Roxanne2603/ENGR1000J-Group1/docs/PROVENANCE.md

> 状态：现行交付快照｜2026-10-23｜未完成整车标定

# 来源、AI辅助与发布范围

源码和资料从组员本地ENGR100项目中按允许清单整理，当前主程序三文件与2026-10-23实际烧录版SHA256一致。本发布保留远程初始提交，不导入整个本地Git历史。

AI辅助：Codex用于控制程序整合、接线梳理、测试操作指导、日志分析、初始标定计算及本仓库整理；历史器件验收代码/记录包含DSH(DeepSeek)辅助。实物操作和“每轮几圈/滚动距离/运动方向”等由组员报告，AI没有把串口命令当作物理测量。报告应按课程要求如实披露实际使用的AI工具和环节。

原始程序保持字节不变。公开说明重写为可独立阅读的交付版本；不整份复制本地聊天、工作日志或课程草稿。上传日志中的本机路径和设备MAC已移除，公开验证JSON只保留可复核的源码/镜像哈希、参数与结果；源件SHA256在MANIFEST.json中记录。

重要边界：软件PASS、REACHED、编译和Flash校验不等于真实轮角、制动、载流或赛道验收；手工圈数/距离为初测。历史设计源件和旧接线Excel明确归档，不自动成为当前施工依据。

所有新增/更新文件都列在[MANIFEST.json](../MANIFEST.json)。无编译镜像、缓存、工具运行目录、令牌或聊天记录。发布前检查暂存清单、文本内容、相对链接和三文件生产哈希，发布后再核远程提交及文件列表。
