Roxanne2603/ENGR1000J-Group1/docs/STATUS.md

> 状态：现行交付快照｜2026-10-23｜未完成整车标定

# 当前交付状态

| 项目 | 已有证据 | 尚未证明 |
|---|---|---|
| 编译及上传 | wheelcal版329595字节程序、26560字节静态RAM；4段写入哈希通过 | 不能代替运动验收 |
| 默认状态 | 启动打印参数；90条控制日志均IDLE、两轮指令0 | 不能代替长期电源稳定性 |
| 电机方向 | 用户按JOG L/R观察，两轮胎底均向车尾，能对应车体前进 | 真实刹停、带载速度和峰值电流 |
| 编码器 | 逐轮通道检查；最新多圈及单圈方向证据支持左正、右负 | 原始圈数精度、反向/漏计数验证及速度交叉核对 |
| 轮径 | 用户报告左右各3圈650mm | 载荷、直线/打滑条件未独立记录；有效直径不是尺量外径 |
| 三路测距 | 三路均初始化；曾有12秒三路全有效窗口 | 最新启动窗口三路均无有效样本，目标几何未记录，需固定挡板复测 |
| 舵机 | 2026-10-09用户报告基本左右/回中可响应，±400µs档曾试过 | 真实轮角、中心、机械限位、响应时间及接头可靠性 |
| 自主控制 | 循墙/限速/锁停逻辑及电脑测试代码已实现 | 无碰撞整圈、最快速度、精确终点及脱机启动 |

`DIRECTION_CHECKED=true`只表示已有当前方向核对记录；`COMMISSIONED=false`、`MOUNTING_CHECKED=false`、`SWEPT_PATH_CHECKED=false`。未知几何、制动、误差等参数保持0。多圈初估不能当高精度标定。

优先后续工作：固定挡板测三路距离/有效间隔；核对换算速度与真实行程；测舵机中心和实际车轮角；低速独立测刹停；核整车扫掠、供电和低速全圈，再逐级提速。

记录必须区分用户现场观察、程序命令/日志与物理测量。参见[数据入口](../data/README.md)。
