Roxanne2603/ENGR1000J-Group1/data/2026-10-23/evidence/cpr-extra3-end-11543--10714.png

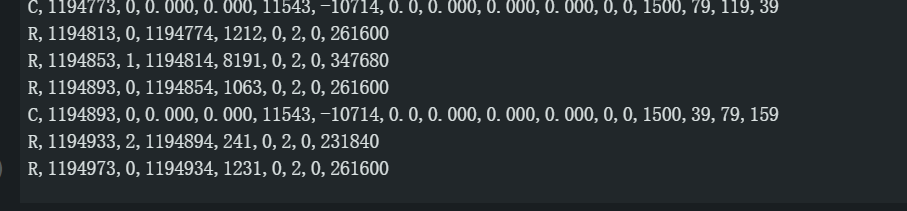
data/2026-10-23/evidence/cpr-extra3-end-11543--10714.png
