Roxanne2603/ENGR1000J-Group1/data/2026-10-23/evidence/cpr-round1-start-0-0.png

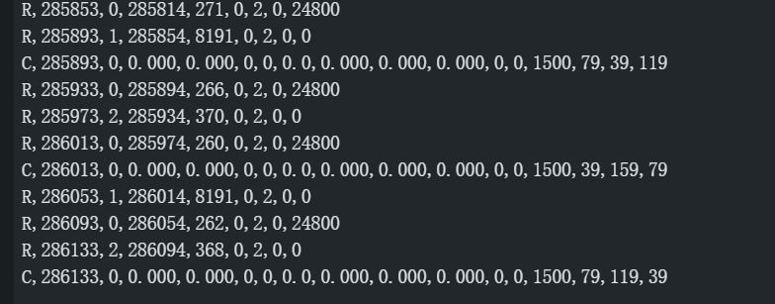
data/2026-10-23/evidence/cpr-round1-start-0-0.png
