Roxanne2603/ENGR1000J-Group1/data/2026-10-23/evidence/encoder-baseline-1737--1018.png

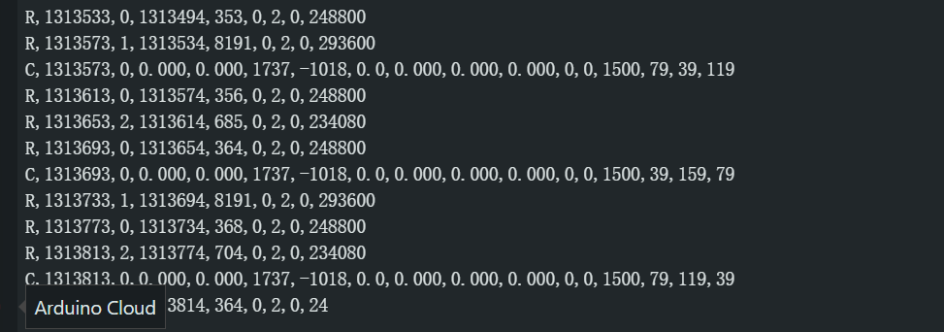
data/2026-10-23/evidence/encoder-baseline-1737--1018.png
