Roxanne2603/ENGR1000J-Group1/data/2026-10-23/evidence/rolling-3turn-650mm-end-13964--13236.png

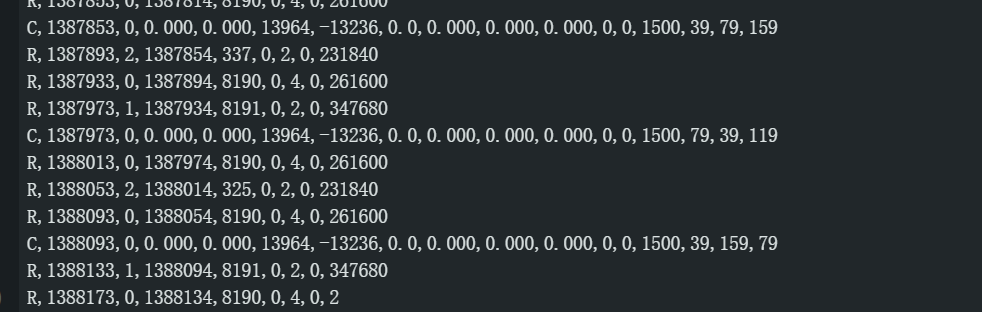
data/2026-10-23/evidence/rolling-3turn-650mm-end-13964--13236.png
