Roxanne2603/ENGR1000J-Group1/hardware/wiring/v2.6-original-reference.xlsx

Sheet: 直连接线
直连接线表 v2.6（杜邦线5V直供，仅新增正极，2026-10-23）
接线规划，未上电验证。仅新增D057公对母红线：固定5V-OUT→主板底部红色长母座丝印5V孔（紧邻原D046 GND孔）。D046原公共地沿用；D058不接。该板5V孔输入能力待核后才上电。
GPIO三排：黑G / 红3V3 / 黄IO。I²C区从上到下：蓝SCL22 / 黄SDA21 / 红3V3 / 黑GND；C1–C5从左向右自贴标签，先量并联与电压。
运行：D057接5V孔，电脑USB拔下；调试：全断电，拔下并绝缘D057主板端，再插电脑USB。D046始终保留。舵机原独立5V分支不改，VADJ留空，驱动B路原待核项保留。
编号 | 用途 | 端点1 / 来源 | 具体插针或端子位置 | 端点2 / 去向 | 电压 / 信号 | 接法与待确认 | 核对
D001 | 驱动控制 | ESP32 GPIO25 | 上方左组 G/3V3/IO：25列黄色IO针 | AT8236 AN1 | 3.3V逻辑 | 母对母信号线直连；按组员反馈已有板载输入下拉，不另加10kΩ电阻。 | □
D002 | 驱动控制 | ESP32 GPIO26 | 上方左组 G/3V3/IO：26列黄色IO针 | AT8236 AN2 | 3.3V逻辑 | 母对母信号线直连；按组员反馈已有板载输入下拉，不另加10kΩ电阻。 | □
D003 | 驱动控制 | ESP32 GPIO32 | 下方 G/3V3/IO：32列黄色IO针 | AT8236 BN1 | 3.3V逻辑 | 母对母信号线直连；按组员反馈已有板载输入下拉，不另加10kΩ电阻。 | □
D004 | 驱动控制 | ESP32 GPIO33 | 下方 G/3V3/IO：33列黄色IO针 | AT8236 BN2 | 3.3V逻辑 | 母对母信号线直连；按组员反馈已有板载输入下拉，不另加10kΩ电阻。 | □
D005 | 不接：旧下拉 | v1曾建议AN1信号线分支 | 本版无需制作信号到GND的电阻支线 | 原外接10kΩ（停用） | 不适用 | 2026-10-10据板载下拉反馈停用；保留v1依据，不采购/焊接此电阻。 | 不接
D006 | 不接：旧下拉 | v1曾建议AN2信号线分支 | 本版无需制作信号到GND的电阻支线 | 原外接10kΩ（停用） | 不适用 | 2026-10-10据板载下拉反馈停用；保留v1依据，不采购/焊接此电阻。 | 不接
D007 | 不接：旧下拉 | v1曾建议BN1信号线分支 | 本版无需制作信号到GND的电阻支线 | 原外接10kΩ（停用） | 不适用 | 2026-10-10据板载下拉反馈停用；保留v1依据，不采购/焊接此电阻。 | 不接
D008 | 不接：旧下拉 | v1曾建议BN2信号线分支 | 本版无需制作信号到GND的电阻支线 | 原外接10kΩ（停用） | 不适用 | 2026-10-10据板载下拉反馈停用；保留v1依据，不采购/焊接此电阻。 | 不接
D009 | 左编码器 | 左电机 A | SPI区下排绿色18针 | ESP32 GPIO18 | 输入3.3V | 保留首台已用18；板上SPI功能本版不启用。 | □
D010 | 左编码器 | 左电机 B | SPI区下排绿色19针 | ESP32 GPIO19 | 输入3.3V | 保留首台已用19。 | □
D011 | 左编码器 | ESP32 3V3 | 上方左组 G/3V3/IO：0列红色3V3针 | 左电机 VCC | 3.3V | 按丝印取电；0列只取电源，不连接GPIO0信号。 | □
D012 | 左编码器 | ESP32 GND | 上方左组 G/3V3/IO：0列黑色G针 | 左电机 GND | 逻辑地 | 单独一根地线；编码器线不接驱动AO/BO输出。 | □
D013 | 右编码器 | 右电机 A | 下方 G/3V3/IO：34/A6列黄色IO针 | ESP32 GPIO34 | 输入3.3V | 34只输入、无内部上拉；程序用INPUT。 | □
D014 | 右编码器 | 右电机 B | 下方 G/3V3/IO：35/A7列黄色IO针 | ESP32 GPIO35 | 输入3.3V | 35只输入、无内部上拉；程序用INPUT。 | □
D015 | 右编码器 | ESP32 3V3 | 下方 G/3V3/IO：34列红色3V3针 | 右电机 VCC | 3.3V | 按丝印取红色3V3针；同列黄色GPIO34另接右编码器A。 | □
D016 | 右编码器 | ESP32 GND | 下方 G/3V3/IO：34列黑色G针 | 右电机 GND | 逻辑地 | 单独一根地线；编码器线不接驱动AO/BO输出。 | □
D017 | T1正前 | ESP32 GPIO21 | I²C区 C1：黄色SDA|21针 | T1 SDA | 3.3V域 | C1–C5是本表从照片左向右自贴的列号；断电核同名针并联。每个模块占一整列的4个针。 | □
D018 | T1正前 | ESP32 GPIO22 | I²C区 C1：蓝色SCL|22针 | T1 SCL | 3.3V域 | C1–C5是本表从照片左向右自贴的列号；断电核同名针并联。每个模块占一整列的4个针。 | □
D019 | T1正前 | ESP32 3V3 | I²C区 C1：红色3V3针 | T1 VCC | 3.3V | C1–C5是本表从照片左向右自贴的列号；断电核同名针并联。每个模块占一整列的4个针。 | □
D020 | T1正前 | ESP32 GND | I²C区 C1：黑色GND针 | T1 GND | 逻辑地 | C1–C5是本表从照片左向右自贴的列号；断电核同名针并联。每个模块占一整列的4个针。 | □
D021 | T1正前 | ESP32 GPIO4 | 上方右组 G/3V3/IO：4列黄色IO针 | T1 XSH | 复位信号 | 每只XSH独立；拉低/高阻释放须核模块上拉电平；INT不接。 | □
D022 | T2左 | ESP32 GPIO21 | I²C区 C2：黄色SDA|21针 | T2 SDA | 3.3V域 | C1–C5是本表从照片左向右自贴的列号；断电核同名针并联。每个模块占一整列的4个针。 | □
D023 | T2左 | ESP32 GPIO22 | I²C区 C2：蓝色SCL|22针 | T2 SCL | 3.3V域 | C1–C5是本表从照片左向右自贴的列号；断电核同名针并联。每个模块占一整列的4个针。 | □
D024 | T2左 | ESP32 3V3 | I²C区 C2：红色3V3针 | T2 VCC | 3.3V | C1–C5是本表从照片左向右自贴的列号；断电核同名针并联。每个模块占一整列的4个针。 | □
D025 | T2左 | ESP32 GND | I²C区 C2：黑色GND针 | T2 GND | 逻辑地 | C1–C5是本表从照片左向右自贴的列号；断电核同名针并联。每个模块占一整列的4个针。 | □
D026 | T2左 | ESP32 GPIO17 | 上方左组 G/3V3/IO：17列黄色IO针 | T2 XSH | 复位信号 | 每只XSH独立；拉低/高阻释放须核模块上拉电平；INT不接。 | □
D027 | T3右 | ESP32 GPIO21 | I²C区 C3：黄色SDA|21针 | T3 SDA | 3.3V域 | C1–C5是本表从照片左向右自贴的列号；断电核同名针并联。每个模块占一整列的4个针。 | □
D028 | T3右 | ESP32 GPIO22 | I²C区 C3：蓝色SCL|22针 | T3 SCL | 3.3V域 | C1–C5是本表从照片左向右自贴的列号；断电核同名针并联。每个模块占一整列的4个针。 | □
D029 | T3右 | ESP32 3V3 | I²C区 C3：红色3V3针 | T3 VCC | 3.3V | C1–C5是本表从照片左向右自贴的列号；断电核同名针并联。每个模块占一整列的4个针。 | □
D030 | T3右 | ESP32 GND | I²C区 C3：黑色GND针 | T3 GND | 逻辑地 | C1–C5是本表从照片左向右自贴的列号；断电核同名针并联。每个模块占一整列的4个针。 | □
D031 | T3右 | ESP32 GPIO13 | 上方右组 G/3V3/IO：13列黄色IO针 | T3 XSH | 复位信号 | 每只XSH独立；拉低/高阻释放须核模块上拉电平；INT不接。 | □
D032 | T4预留4 | ESP32 GPIO21 | I²C区 C4：黄色SDA|21针 | T4 SDA | 3.3V域 | C1–C5是本表从照片左向右自贴的列号；断电核同名针并联。每个模块占一整列的4个针。 | 选配 □
D033 | T4预留4 | ESP32 GPIO22 | I²C区 C4：蓝色SCL|22针 | T4 SCL | 3.3V域 | C1–C5是本表从照片左向右自贴的列号；断电核同名针并联。每个模块占一整列的4个针。 | 选配 □
D034 | T4预留4 | ESP32 3V3 | I²C区 C4：红色3V3针 | T4 VCC | 3.3V | C1–C5是本表从照片左向右自贴的列号；断电核同名针并联。每个模块占一整列的4个针。 | 选配 □
D035 | T4预留4 | ESP32 GND | I²C区 C4：黑色GND针 | T4 GND | 逻辑地 | C1–C5是本表从照片左向右自贴的列号；断电核同名针并联。每个模块占一整列的4个针。 | 选配 □
D036 | T4预留4 | ESP32 GPIO27 | 上方左组 G/3V3/IO：27列黄色IO针 | T4 XSH | 复位信号 | 每只XSH独立；拉低/高阻释放须核模块上拉电平；INT不接。 | 选配 □
D037 | T5预留5 | ESP32 GPIO21 | I²C区 C5：黄色SDA|21针 | T5 SDA | 3.3V域 | C1–C5是本表从照片左向右自贴的列号；断电核同名针并联。每个模块占一整列的4个针。 | 选配 □
D038 | T5预留5 | ESP32 GPIO22 | I²C区 C5：蓝色SCL|22针 | T5 SCL | 3.3V域 | C1–C5是本表从照片左向右自贴的列号；断电核同名针并联。每个模块占一整列的4个针。 | 选配 □
D039 | T5预留5 | ESP32 3V3 | I²C区 C5：红色3V3针 | T5 VCC | 3.3V | C1–C5是本表从照片左向右自贴的列号；断电核同名针并联。每个模块占一整列的4个针。 | 选配 □
D040 | T5预留5 | ESP32 GND | I²C区 C5：黑色GND针 | T5 GND | 逻辑地 | C1–C5是本表从照片左向右自贴的列号；断电核同名针并联。每个模块占一整列的4个针。 | 选配 □
D041 | T5预留5 | ESP32 GPIO23 | SPI区下排绿色23针 | T5 XSH | 复位信号 | 每只XSH独立；拉低/高阻释放须核模块上拉电平；INT不接。 | 选配 □
D042 | 舵机信号 | ESP32 GPIO14 | 上方右组 G/3V3/IO：14列黄色IO针 | 舵机橙黄色信号线 | 3.3V脉冲 | 按实物照橙黄线接GPIO14黄色IO针；三针插头分线，红/棕线另接降压固定5V/GND。型号与3.3V阈值仍待核。 | □
D043 | 舵机供电 | 降压板固定 5V-OUT | 中间红色5V-OUT排针，选一针 | 舵机红线（电源＋） | 固定5.0V | 舵机红线仍单独接固定5V；主控D057另取固定5V，负极沿用D046，不串经过舵机插头。核共享输出、主干及接头能承担舵机峰值与主控/外设总负载。 | □
D044 | 舵机供电 | 舵机棕线（电源−） | 固定5V-OUT旁黑色GND排针，选一针 | MP2491C降压板输出GND | 功率地 | 舵机棕线接固定5V区黑GND，主板地线接另一空闲黑GND；舵机电流不经主板细线，峰值/接头载流仍待核。 | □
D045 | 电脑USB烧录/串口 | 电脑USB（与D057外供互斥） | 主板左侧USB口 | ESP32 USB口 | USB 5V；外供互斥 | 先全断电，拔下D057在主板5V孔的公头并绝缘，再接电脑USB。运行接回D057前先拔电脑USB；只关电机B路不等于已断开降压5V。D046保留。 | □
D046 | 公共地兼主控电源− | ESP32 GND | 底部红色母座：靠5V的第一个GND孔 | 降压固定5V区另一黑GND针 | GND／主控电源回流 | 沿用原D046，不新增地线：主板底部红色母座原GND孔→降压板5V区原黑GND针。直供时兼主控及板载3V3外设负极，核导通/接触/压降；电机功率回流不走此线。 | □
D047 | 驱动共地 | 驱动左侧5V与3V3之间GND针 | 上方右组 G/3V3/IO：14列黑色G针 | ESP32 GND | 逻辑地 | 驱动左侧长黑排针，取5V与3V3之间标GND的针接主板14列黑G；只作信号参考，Vin−另接B路功率黑线。 | □
D048 | 一拖二输入 | 电池主电源插头 | 电池主电源插头接并联一拖二的单输入端 | 并联一拖二输入端 | 电池原电压 | 选并联，禁用串联；接口尺寸、公母按实际金属触点核对。截图XT30未确认匹配；本行不再代表额外接一根公共地线。 | 接口待核
D049 | 驱动供电＋ | 一拖二支路B红线（＋） | 支路B转红黑双芯电源线：红线接驱动Vin+ | 驱动上方蓝色Vin+螺丝端子 | 电池原电压 用户测12.53V | 条件规划，先断开B支路。须核同版驱动允许3S满电及接口/载流；拆除旧VADJ动力线。动力线不用普通杜邦母头。 | 兼容待核
D050 | 驱动供电− | 一拖二支路B黑线（−） | 支路B转红黑双芯电源线：黑线接驱动Vin− | 驱动上方蓝色Vin−螺丝端子 | 独立功率回流 | 与D049成对，黑线直接回一拖二B负极；不用降压输出黑排针或D047信号地替代。B支路两根线一起待接。 | 随B路待接
D051 | 降压输入A路 | 一拖二支路A的DC公头 | 支路A转DC公头，插降压板DC输入圆孔 | 降压板DC输入圆孔 | 标称11.1V 满电12.6V | 核DC尺寸与中心极性。XT型分线头须配匹配XT转DC电源线；原DC线仅在电池端可拆且接口匹配时复用。蓝IN端不另接第二电源。 | 接口待核
D052 | A路负极说明 | 支路A DC头负极（已包含） | A路DC插座同时接入正负极，无需另拉负极线 | 降压DC插座负极（IN−） | 输入参考地 | D051已包含此连接；D052不另接。两支路负极在并联一拖二内相通，断电确认连通；G1/G2/G3旧接头标签不用。 | 不另接
D053 | 电机动力 | AT8236 AO1 | 驱动MOTOR-A/B插座的对应丝印针 | 左电机 M+ | H桥输出 | 按功能逐针做PH2.0转接；电机尾板线序不同，不硬插整只未知六针线；M−不接地。 | □
D054 | 电机动力 | AT8236 AO2 | 驱动MOTOR-A/B插座的对应丝印针 | 左电机 M− | H桥输出 | 按功能逐针做PH2.0转接；电机尾板线序不同，不硬插整只未知六针线；M−不接地。 | □
D055 | 电机动力 | AT8236 BO1 | 驱动MOTOR-A/B插座的对应丝印针 | 右电机 M+ | H桥输出 | 按功能逐针做PH2.0转接；电机尾板线序不同，不硬插整只未知六针线；M−不接地。 | □
D056 | 电机动力 | AT8236 BO2 | 驱动MOTOR-A/B插座的对应丝印针 | 右电机 M− | H桥输出 | 按功能逐针做PH2.0转接；电机尾板线序不同，不硬插整只未知六针线；M−不接地。 | □
D057 | 主控供电＋（唯一新增） | 降压板固定5V-OUT | 中间红色5V-OUT空闲针→主板底部红色长母座丝印5V孔（紧邻D046 GND孔） | ESP32底部红色长母座的5V孔；不是旁边GND孔，也不是GPIO红色3V3孔 | 固定5.0V；输入能力待核 | 仅一根红色公对母杜邦线：母头套降压5V针，公头插主板5V孔。先核本板该孔允许5V输入，电脑USB拔下。无空闲针则先解决分线，不挤双头。 | 待核/待接 □
D058 | 不接（旧USB负极） | 旧USB方案留号 | 不新增、不接此线 | 主控负极沿用原D046公共地 | 本版停用 | 旧版USB转接负极编号仅留档；本版不需要USB转接头或第二根GND线。原D046须可靠，D057为唯一新增导线。 | 不接

Sheet: 供电与核对
供电与核对 v2.6（杜邦线5V直供，2026-10-23，未实测）
核对项 | 本版安排 | 条件 / 操作 | 实测值 / 原文 | 核对
主板定位 | 按照片朝向与丝印找针 | GPIO号优先于颜色；SPI区18/19/23取下排绿色针；下方34/A6、35/A7的黄IO只作输入。 |  | □
I²C分线列 | C1正前 / C2左 / C3右 | 从照片左到右自贴C1–C5；断电量同名SDA/SCL/3V3/GND针并联。前三列各模块一整列4针，XSH另接。 |  | □
逻辑供电 | 编码器×2与ToF×3取3.3V | 测模块端VCC–GND、I²C上拉高电平与整套负载温升；主板排针数量不证明稳压器载流足够。 |  | □
编码器线序 | 本批M+ M− GND VCC B A | 按组员已确认尾板丝印逐根映射；转接线脱离两端后查低阻与跨线短接；34/35没有内部上拉。 |  | □
输入下拉 | 已有板载下拉；不加外接4×10kΩ | 依据组员反馈；核下拉覆盖AN1/AN2/BN1/BN2。D005–D008仅保留旧方案；启动/复位低电平仍待实测。 |  | □
AT8236控制 | AN1/2=25/26；BN1/2=32/33 | 每路两输入，PWM在其中一端，另一端低；换向先停。没有额外EN/PWM/STBY。需配套固件。 |  | □
动力电源 | 3S电池经并联一拖二分为A/B两路 | 电池1300mAh / 3S / 11.1V / 30C，用户2026-10-11报告总电压12.53V（负载条件未给）。并联不降压；驱动公布5–12V，同版本满电3S适配待核，B路先断开。 |  | □
舵机供电 | 固定5V分别供舵机和主控5V孔 | 舵机红/棕原接法保留；主控仅新增D057正极，原D046兼负极，不串经舵机插头。固定5V需实测，不看VADJ数码管。共享负载与掉压待核。 |  | □
舵机信号 | 舵机橙黄信号线→GPIO14黄色IO | 按照片棕/红/橙黄分别负极/正极/信号；型号针序和3.3V阈值待核。三针插头分线，不整体插主板G/3V3/IO。 |  | □
共地与回流 | 原D046公共地兼主控供电负极 | 主板原GND孔→降压原黑GND针保持；主控及板载3V3外设电流经D046回流，核接触和压降。舵机/电机各自原功率回流不改；电机不走D046。 |  | □
多ToF改址 | XSH=4/17/13；地址0x30/31/32 | 先全拉低再逐只释放改7位地址；上电/模块复位后重新改址。XSH用拉低/高阻释放须核模块上拉，INT不用。 |  | □
五路选配 | C4/C5；XSH=27/23 | 加第四/第五模块时接黄色行，地址0x33/34；I²C仍21/22。不用GPIO16、36/39，不迁移18/19。 |  | 选配 □
主控电源切换 | 运行D057外供；调试电脑USB，互斥 | 先全断电，拔下并绝缘D057主板5V孔端，再接电脑USB；D046保留。接回D057前先拔电脑USB。不同时接两路5V；只关电机B路不能断开降压5V。 |  | □
程序同步 | A17程序已编译；脱机启动待补 | 赛道程序track_racer上电IDLE，仍需串口ARM/RUN。改供电不增加脱机启动；单按EN仍待机。物理启动按钮/脱机启动流程尚待实现及验证，未据此宣称可独立比赛。 |  | □
上电顺序 | 先核5V输入能力，再断电改线/分步上电 | 核本板5V孔允许输入；电池/USB全断，B路和舵机断开。只给A路，量固定5V后再断电接D057；母头降压红5V针、公头主板5V孔，地沿用D046。USB不接，分步测主控/舵机掉压。 |  | □
主板参考地位置 | 主板底部GND孔接降压5V区黑GND | D046保持原GND孔。新增D057插紧邻它、明确丝印5V的孔；不是GND，不是GPIO三排中的红3V3。只按丝印识别，不猜左右第几孔。该孔允许5V输入仍待核。 |  | □
D048一拖二输入 | 电池主电源插头接分线头单输入端 | 新增分线头插在电池主电源接口与两条负载线之间。选并联。XT30/XT60及公母尚未核，不凭商品截图定SKU；仅有DC头不能直接插XT30。 |  | □
D049/D050驱动B路 | B红接上方Vin+，B黑接上方Vin− | B路用匹配插头转红黑双芯铜电源线，驱动端适当剥线或配端头压入上方蓝色Vin端子。本件3S满电兼容及载流未核，B路保持断开；不要用下方Vout端子。 |  | □
来源与版本（2026-10-23杜邦直供替代USB转接；旧USB文件留档）
测试板照片 | ESP32-WROOM-32E测试板 | 组员本聊天58e28141…jpg：G/3V3/IO、多列I²C、SPI及下排输入针；整板完整型号/原理图未获 | 本件实物照片 | 来源
驱动照片 | AT8236 / YB-INIT03-V1.0 | 组员本聊天4acca974…jpg：AN2 AN1 BN2 BN1；AO/BO；Vin5–12V；这张是商品图，须与到货板一致 | 商品图 | 来源
舵机照片 | GODBOT DIGITAL SERVO 20kg | 组员本聊天2be1182c…jpg：DC4.8–6.8V；完整型号/堵转电流/输入阈值未知 | 商品图 | 来源
测距/降压照片 | 野火VL53L0X / 亚博MP2491C | 89e725…jpg：VCC GND SDA SCL XSH INT；2599c…jpg：VADJ/5V/3V3及GND，各支路持续额定值未核 | 商品图 | 来源
驱动控制依据 | 亚博AT8236官方教程 | https://www.yahboom.net/public/upload/upload-html/1740735557/AT8236%20drive%20tutorials.html | 每路两输入PWM | 官方
驱动电流口径1 | 亚博模块介绍 | https://www.yahboom.net/public/upload/upload-html/1692605631/Introduction%20of%20Module.html | 默认2A/最大4A | 官方
驱动电流口径2 | 亚博商品页 | https://category.yahboom.net/products/dual-md-module | 3.6A/峰值6A；与前页待核 | 官方
降压依据 | 亚博MP2491C降压供电模块官方页 | https://category.yahboom.net/products/asrm | 6–24V输入；持续带舵机能力未测 | 官方
野火资料入口 | 小智激光测距模块 | https://doc.embedfire.com/products/link/zh/latest/module/sensor/ebf_vl53l0x.html | 原理图下载在百度网盘，未取到 | 官方
ToF芯片依据 | ST VL53L0X datasheet | https://www.st.com/resource/en/datasheet/vl53l0x.pdf | XSH低有效；板级电平另核 | 官方
编码器供电依据 | 亚博MD520官方介绍 | https://www.yahboom.net/public/upload/upload-html/1740736196/0.%20Motor%20introduction%20and%20usage.html | 3.3–5V编码器内置上拉整形 | 官方
GPIO依据 | Espressif ESP32 GPIO文档 | https://docs.espressif.com/projects/esp-idf/en/latest/esp32/api-reference/peripherals/gpio.html | 34–39输入；36/39中断约束 | 官方
GPIO16变体依据 | Espressif WROOM-32E datasheet v2.1 | https://www.espressif.com/sites/default/files/documentation/esp32-wroom-32e_esp32-wroom-32ue_datasheet_en.pdf | 带封装内PSRAM变体占GPIO16 | 官方
一拖二与支路线材 | 并联分线头、A路转DC、B路转红黑线 | 主接口尺寸/公母、DC尺寸/极性和额定载流待核。若仅有不可拆DC头，图中XT分线头不能直接用。公共主干流过两支路总电流；动力不用普通杜邦线。 | 用户截图/接口待核 | 来源
降压模块接法 | 固定5V→主板底部5V孔；GND沿用D046 | 唯一新增D057公对母红线：母头套中间红5V-OUT空闲针，公头插主板底部红色长母座丝印5V孔（紧邻原D046 GND）。不接VADJ/3V3/电池原压；不用USB转接头。 |  | □
两支路载流与兼容 | 共享固定5V：舵机＋主控＋主控外设 | 共享负载含舵机＋ESP32/USB桥＋主板3V3外设。核D057正极与原D046负极接触/载流和主板端电压；舵机动作观察掉压/复位。模块标称总电流不等于单针能力。驱动B路待核保留。 |  | □
实际供电依据 | 用户指定单根正极；同板5V输入待核 | 2026-10-23用户要求公对母杜邦直供、公共地沿用。已有记录识别5V孔，不等于已证实输入额定。Espressif官方板供电互斥仅作原则：https://docs.espressif.com/projects/esp-dev-kits/en/latest/esp32/esp32-devkitc/user_guide.html | 用户反馈/官方说明 | 来源
