Roxanne2603/ENGR1000J-Group1/hardware/reference/baseplate.SLDPRT

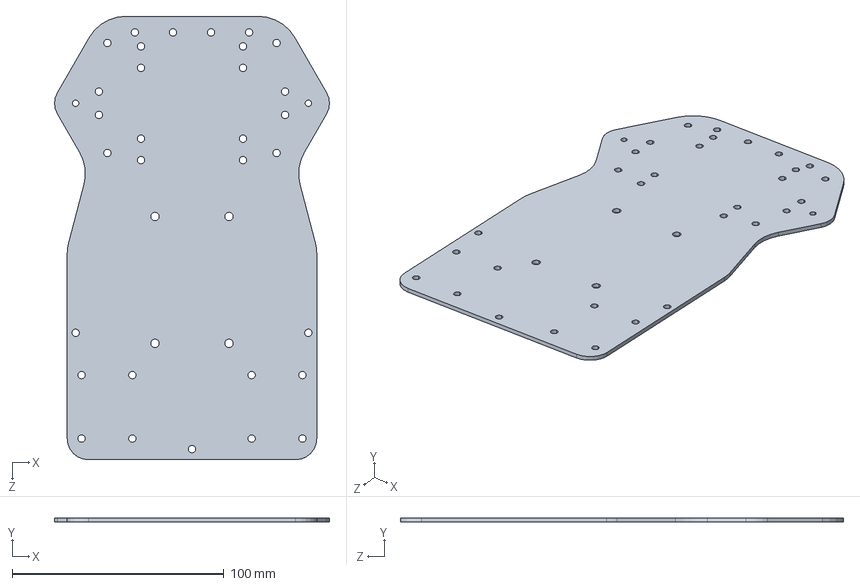
[picture p5: CAD file, 2026-10-26]
hardware/reference/baseplate.SLDPRT
130.0 x 2.00 x 209.6 mm
