Roxanne2603/ENGR1000J-Group1/docs/WIRING.md

> 状态：现行交付快照｜2026-10-23｜未完成整车标定

# 当前实车接线

本表优先于存档Excel中的原规划：用户确认右侧四线接I²C自贴C2、左侧接C3；右XSH接GPIO17、左接GPIO13。C1/C2/C3是分线列，软件身份由独立XSH控制，不由列号识别。

| 接口 | 连接 |
|---|---|
| AT8236 AN1 / AN2 | ESP32 GPIO25 / GPIO26，黄色IO |
| AT8236 BN1 / BN2 | ESP32 GPIO32 / GPIO33，黄色IO |
| 左电机 M+ / M− | AO1 / AO2 |
| 右电机 M+ / M− | BO1 / BO2 |
| 左编码器 A / B | GPIO18 / GPIO19 |
| 右编码器 A / B | GPIO34 / GPIO35；这两脚无内部上拉 |
| 编码器 VCC / GND | 3V3 / GND，原独立接法保留 |
| 三只VL53L0X SDA / SCL | GPIO21 / GPIO22，各自VCC接3V3、GND接GND |
| 前XSH / 左XSH / 右XSH | GPIO4 / GPIO13 / GPIO17 |
| 软件前/左/右地址及索引 | 0x30/0；0x31/1；0x32/2 |
| 舵机信号 | GPIO14 |
| 舵机红/棕线 | 降压固定5V-OUT / 同区GND；独立供电分支 |
| D046公共地 | 主板GND ↔ 降压固定5V区GND，原线保留 |
| D047驱动信号地 | 驱动标GND ↔ 主板GND；不能代替电机功率负极 |
| 电机B路红/黑D049/D050 | 驱动上方、ON/OFF旁Vin+ / Vin−；不接下方Vout |

## D057与电脑USB

- D057是唯一新增外部正极线：降压固定5V-OUT空闲针 → 主板5V孔；原D046作为回流。D058旧USB转接负极不接。
- 本项目记录照片朝向为USB左、底部红7孔母座在下，从左到右：5V / RST / 3V3 / 5V / GND / GND / VIN；拟用第4孔5V和第5孔GND。换板或朝向不同必须重新核丝印。
- 板厂及同板电源原理图尚未唯一确认；5V孔输入能力和USB隔离不能仅靠丝印或另一款DevKitC推断。外供亮灯也不是额定/带载验收。
- **USB与D057外部5V互斥**。当前烧录和采集采用电池断开、D057降压端断开绝缘、电脑USB单供。先全断电再插拔接线。
- 主控3V3/GPIO不能接5V。驱动板5V/3V3输出不额外并到主控电源。GPIO0不接永久GND跳线。

## 动力测试边界

电机驱动厂家推荐输入5–12V，用户本次报告电源12V；3S满电12.6V不能自动当作兼容。动力支路使用合适线材/接头，不能靠普通杜邦线或D046承担电机功率回流。电机M−是H桥输出，不接公共地。

只测轮向时固定车架、四轮离地，主控USB供电且D057断开；舵机红线暂断。先确认IDLE再给合格的驱动动力，逐轮人工发命令。异常先切驱动动力。保持手、头发和线束远离轮胎。

存档[原v2.6 Excel](../hardware/wiring/v2.6-original-reference.xlsx)保留原规划和编号，**其左右XSH17/13已由本表当前13/17替代**；不把它当作完整上电许可。
