Roxanne2603/ENGR1000J-Group1/docs/CALIBRATION.md

> 状态：现行交付快照｜2026-10-23｜未完成整车标定

# 当前初测数据与更正轨迹

## 方向与每圈计数

用户观察两轮JOG方向均能推车前进，保留电机符号+1/-1。原始编码器通道已做逐轮检查。早期用户报告的一次左前进半圈计数-485与后续两次明确方向记录冲突，旧版曾据此设编码器-1/-1；新数据中左同JOG L方向五圈+4083、追加一圈+825、重复五圈+4158，故当前更正为编码器+1/-1。旧负号结论不作为当前配置，截图和更正关系保留。

| 轮次 | 起点左/右 | 终点左/右 | 报告圈数 | 每圈绝对计数左/右 |
|---|---|---|---|---|
| 第一组 | 0 / 0 | 4083 / -4135 | 各5圈 | 816.6 / 827.0 |
| 左追加 | 4083 / -4135 | 4908 / -4135 | 左1圈 | 825 / — |
| 第二组 | 4908 / -4135 | 9066 / -8257 | 各5圈 | 831.6 / 824.4 |
| 附加三圈 | 9066 / -8257 | 11543 / -10714 | 用户报告各3圈 | 825.67 / 819.0 |

源码初值采用前两组及左追加圈：左9066/11≈824.2，右8257/10=825.7。两个五圈组的相对差左约1.82%、右约0.315%；尚不能区分人工对齐误差、圈数偏差、回摆或漏计数。后续三圈没有覆盖初值；不能称高精度或反向验收。

## 滚动轮径

用户报告左右各3圈均65cm。每圈滚动距离650/3≈216.67mm，WHEEL_MM=650/(3π)≈68.967mm。它是有效滚动直径初测，不是标称65mm，也不是直接尺量轮胎外径。载荷、直线和打滑情况未独立录像或量化，需要用真实行程/速度再核。

## 测距及舵机

2026-10-23右侧复测12秒：前150/150、左75/75、右75/75有效，但无已知固定目标距离，不能拿此窗口做bias或可靠距离标定。当前固件最新启动窗口：前0/135、左0/67、右0/67有效，环境目标未记录。无效样本不能当作前方自由空间。

2026-10-04旧单件固定挡板汇总：100mm档548/548有效、bias−8.4mm、sigma3.85mm、范围77–100mm；200mm档547/547有效、bias+4.1mm、sigma2.27mm、范围199–211mm。两档最坏无新数据约37ms。来自当时用户截图转录的汇总，逐样本CSV未取得；不是本车三路标定，不能统一加/减某个固定偏移。

2026-10-09用户报告舵机基本左右/回中可动，±400µs档试过；实际轮角、中心、响应时间、供电峰值和机械扫掠未量化。当前程序SERVO_LEFT_SIGN仍待实际左右方向确认。

原始计数与截图见[data](../data/README.md)；初值与未知项以[config.h](../tools/chassis/track_racer/config.h)为准，不由测试模板猜填。
