Roxanne2603/ENGR1000J-Group1/tools/chassis/power_on_test/README.md

> 状态：现行交付快照｜2026-10-23｜未完成整车标定

# 历史A15自动上电测试，仅留作代码参考

**该程序上电会自动执行动作，不是当前赛车入口。** 默认使用相邻track_racer目录。

旧A15 v1.2在倒数后给后轮77/255约2秒，再发舵机中/左/中/右指令。verify_serial.py是旧串口软件流程验证工具，也不能在接动力时随意运行。历史软件验证是在电机动力关闭条件下完成，不代表物理方向或载流验收。

若重用该程序，先阅读.ino和Python源码并断动力，不能把本次track_racer的上电待机行为套用到它。
