Roxanne2603/ENGR1000J-Group1/tools/chassis/track_racer/tests/fixture_config.h

#pragma once
// SYNTHETIC HOST-TEST FIXTURE ONLY. Not measured car parameters.
namespace cfg {
constexpr bool COMMISSIONED=true,DIRECTION_CHECKED=true,MOUNTING_CHECKED=true,SWEPT_PATH_CHECKED=true;
constexpr int MOTOR_SIGN[2]={1,-1},ENCODER_SIGN[2]={1,1},SERVO_LEFT_SIGN=-1;
constexpr int CENTER_US=1500,LEFT_US=1200,RIGHT_US=1800,MAX_DUTY=100;
constexpr float WIDTH_MM=200,WHEELBASE_MM=180,REAR_TRACK_MM=160;
constexpr float WHEEL_MM[2]={65,65},CPR4[2]={836,836};
constexpr float FRONT_INSET_MM=10,SIDE_INSET_MM[2]={0,0};
constexpr float LEFT_ANGLE_DEG=25,RIGHT_ANGLE_DEG=25,MIN_TURN_RADIUS_MM=400;
constexpr float BRAKE_MPS2=0.6f,REACTION_S=0.15f,LATERAL_MPS2=0.12f;
constexpr float ERROR_MM[3]={10,10,10},BIAS_MM[3]={0,0,0};
constexpr float CERTIFIED_MAX_MM[3]={2000,2000,2000};
constexpr float MAX_WHEEL_MPS=0.4f,FF_DUTY_PER_MPS[2]={100,100},FF_STATIC[2]={20,20};
constexpr float INITIAL_MAX_MPS=0.2f,ACCEL_MPS2=0.2f;
constexpr float WALL_KP_RAD_PER_MM=0.0025f,WALL_KD_RAD_S_PER_MM=0.00045f;
constexpr float MIN_CLEAR_MM=35,FRONT_RESERVE_MM=70,SIDE_SLOW_MM=85;
constexpr unsigned FRONT_AGE_MS=150,SIDE_AGE_MS=220,COMMAND_LEASE_MS=80,BRAKE_HOLD_MS=2000;
constexpr bool FOLLOW_RIGHT=true;
}
